karlp/kcell-faker/README.md

fake a load cell, for testing _functional_ behaviour with changing loads.

this is _NOT_ intended for use with calibration or accuracy testing, but to help simulate response to changing loads

USB (or wifi/bt....) control of a bridge differential....
