karlp/kcell-faker/fw/README.md

# Intent
USB "network" device so that UI can be http api, over either usb or wifi
USB MSD so that "echo <value> > control_file" can work as an easy API too
Micropython, because, let's do things easy

# References
https://github.com/i-am-shodan/USBArmyKnife has a lot of overlapping tech at play, though (obviously) very different applications

micropython will need very recent work to get usb device in python land: https://github.com/micropython/micropython/pull/15108
