karlp/kcell-faker/(commit log)

2024-09-27 more mpns
    [kcell-faker.kicad_sch]
2024-09-29 3d: esp32-s3-mini-1
    unlicesed for distribution, archived for pesonal use.
    Source: https://www.3dcontentcentral.com/Download-Model.aspx?catalogid=171&id=2035880
2024-09-29 Preliminary check stage
    most parts mounted, most parts filled. roughly placed for sanity.
    [bonus_io.kicad_sch, bridge_sim.kicad_sch, kcell-faker.kicad_pcb, kcell-faker.kicad_sch, power_dbg.kicad_sch]
2024-09-29 Save current state
    We're thinking of adding a second stage "fine" tune, because... why not!
    We're at ~$60 assembled for 5 boards, with everything optional filled
    in, so adding 5x$1 to have the second range seems "free"?
    [bonus_io.kicad_sch, bridge_sim.kicad_sch, kcell-faker.kicad_pcb, kcell-faker.kicad_sch, power_dbg.kicad_sch]
2024-09-29 add a second channel of resolution
    [bridge_sim.kicad_sch, kcell-faker.kicad_pcb]
2024-09-30 cleanup a bit
    use red+green leds, sch on .100 grid, hook up more pins
    [bridge_sim.kicad_sch, kcell-faker.kicad_pcb, kcell-faker.kicad_sch, power_dbg.kicad_sch]
2024-09-30 add the PWM controlled simulation
    pros: as much resolution as your pwm
    pros: less resistors that "need" to be low noise
    cons: no escaping pwm noise into the signal
    cons: needs an opto to truly separate excitation voltage from the
    control side
2024-09-30 add the pwm method as an alternate impl
    TODO: replace all resistors with 0805 so that precision _can_ be
    soldered if desired
    [bonus_io.kicad_sch, bridge_sim.kicad_sch, kcell-faker.kicad_pcb, kcell-faker.kicad_sch, power_dbg.kicad_sch]
2024-09-30 make a basic quick lib with jlc parts will need extraction
    Switch to 0805 for bridge resistors
    switch to plain opto, we already have pulls and a fet. (Could the other
    one have directly pulled the resistor? (probably)
    [bonus_io.kicad_sch, bridge_sim.kicad_sch, kcell-faker.kicad_pcb, kcell-faker.kicad_sch, power_dbg.kicad_sch]
2024-10-01 add 3 OC outputs
    [bonus_io.kicad_sch, bridge_sim.kicad_sch, kcell-faker.kicad_pcb, kcell-faker.kicad_sch, power_dbg.kicad_sch]
2024-10-01 switch transistor outputs to ULN2003A
    more dedicated, more smart
    [bonus_io.kicad_sch, kcell-faker.kicad_pcb]
2024-10-01 overhaul heavily
    Move to four connectors for open collector. the uln2303a can then be
    used for steppers even if desired.
    Relayout the board completely now that we have these extra connectors
    [bonus_io.kicad_sch, bridge_sim.kicad_sch, kcell-faker.kicad_pcb, kcell-faker.kicad_sch, power_dbg.kicad_sch]
2024-10-02 Add logos and mounting holes
    Straighen up some stuff, align better, untangle transistor outputs
    Should we add pins for teh spare channels? we have the ios?
    [bonus_io.kicad_sch, kcell-faker.kicad_pcb, kcell-faker.kicad_sch]
2024-10-02 re-wire to share "precision" resistors
    Rewire to make the a-b-wiper connections operate in the expected order
    (higher code value => higher diff voltage) and therefore also make the
    routing simpler, and allow sharing the 33k resistor at least.
    The 150k resistor for the second range digipot is balanced by the 220k
    bridge resistor, which is "too much" if you're using PWM mode, but
    you're resoldering things if you want to use this PWM mode anyway, so
    that's ok.
    [bridge_sim.kicad_sch, kcell-faker.kicad_pcb]
2024-10-02 erc, board stackup
    board stackup for jlc 7628, for 90 ohm usb. netclasses added, but not
    connected. erc started, fixed up more grid issues, pushed some more text
    and added the basic power islands
    [bonus_io.kicad_sch, bridge_sim.kicad_sch, kcell-faker.kicad_pcb, kcell-faker.kicad_sch, power_dbg.kicad_sch]
2024-10-03 add some ntoes from falstad that an opto by itself is ok
    it really should be, you shouldn't need the fet too, at the speeds we're
    likely to be attempting to pwm at?
    [bridge_sim.kicad_sch]
2024-10-03 pcb: text for switching to PWM mode
    [kcell-faker.kicad_pcb]
2024-10-04 fw: doc for usb on esp32-s3 micropy
2024-10-06 marel: fix footprint for logo to be on silk
2024-10-06 quick route stab
    do we want to have a better jumper option for gpio3? yes?
    add silk for version, source, description
    review last expansion options (pins for ulnx outputs? silk for jtag,
    silk for ...?
    [bridge_sim.kicad_sch, kcell-faker.kicad_pcb, kcell-faker.kicad_sch, power_dbg.kicad_sch]
2024-10-07 "final" rev1?
    [bonus_io.kicad_sch, bridge_sim.kicad_sch, kcell-faker.kicad_pcb, kcell-faker.kicad_sch]
2024-10-07 last touch
    [kcell-faker.kicad_pcb]
2024-10-08 syms: use "LCSC Part #" instead of "LCSC Part#"
    makes the kicad->jlc export plugin work without local tweaks
2024-10-11 footprints: import 2x5x1.27mm pitch and add arrow
    Everybody hates the long bar for pin1, use a small arrow like other
    footprints
2024-10-11 update to match library changes, update to include repo
    After moving all in house, label the board with a correct internal url
    Updated the library to have new "LCSC Part #" instead of "LCSC Part#"
    and updated all symbols to match that. Updated to the neweer standard
    14/16 pin usb connector symbols
    _should_ be final for gerbesr
    [bonus_io.kicad_sch, bridge_sim.kicad_sch, kcell-faker.kicad_pcb, kcell-faker.kicad_sch, power_dbg.kicad_sch]
2024-10-11 resynced to pcb to get symbol updates
    found out that the production files didn't have the right symbol updates
    for the jlc data, so resynced all again
    [kcell-faker.kicad_pcb, power_dbg.kicad_sch]
2024-10-11 last minute push traces for more space
    Don't route the bends right beside the pins if we don't need to.
    [kcell-faker.kicad_pcb]
2024-10-11 yet more part number syncing
    Because parts go to pcb as well, lots more syncing ws needed. hopefully
    this will be more streamlined in future
    [bonus_io.kicad_sch, bridge_sim.kicad_sch, kcell-faker.kicad_pcb, kcell-faker.kicad_sch, power_dbg.kicad_sch]
2024-10-11 include gerbers ordered with jlc
    jcl order W2024101123481015
    [bom.csv, designators.csv, positions.csv]
2024-10-11 move all hw down in preparation for fw
    [bonus_io.kicad_sch, bridge_sim.kicad_sch, kcell-faker.kicad_pcb, kcell-faker.kicad_sch, power_dbg.kicad_sch]
2024-10-11 drop the old lcsc part#
    keep just the "LCSC Part #" that the plugin wants, drop the "LCSC Part#"
    [bonus_io.kicad_sch, bridge_sim.kicad_sch, kcell-faker.kicad_sch, power_dbg.kicad_sch]
